afarhan/antuino/antuino_schematic.pdf

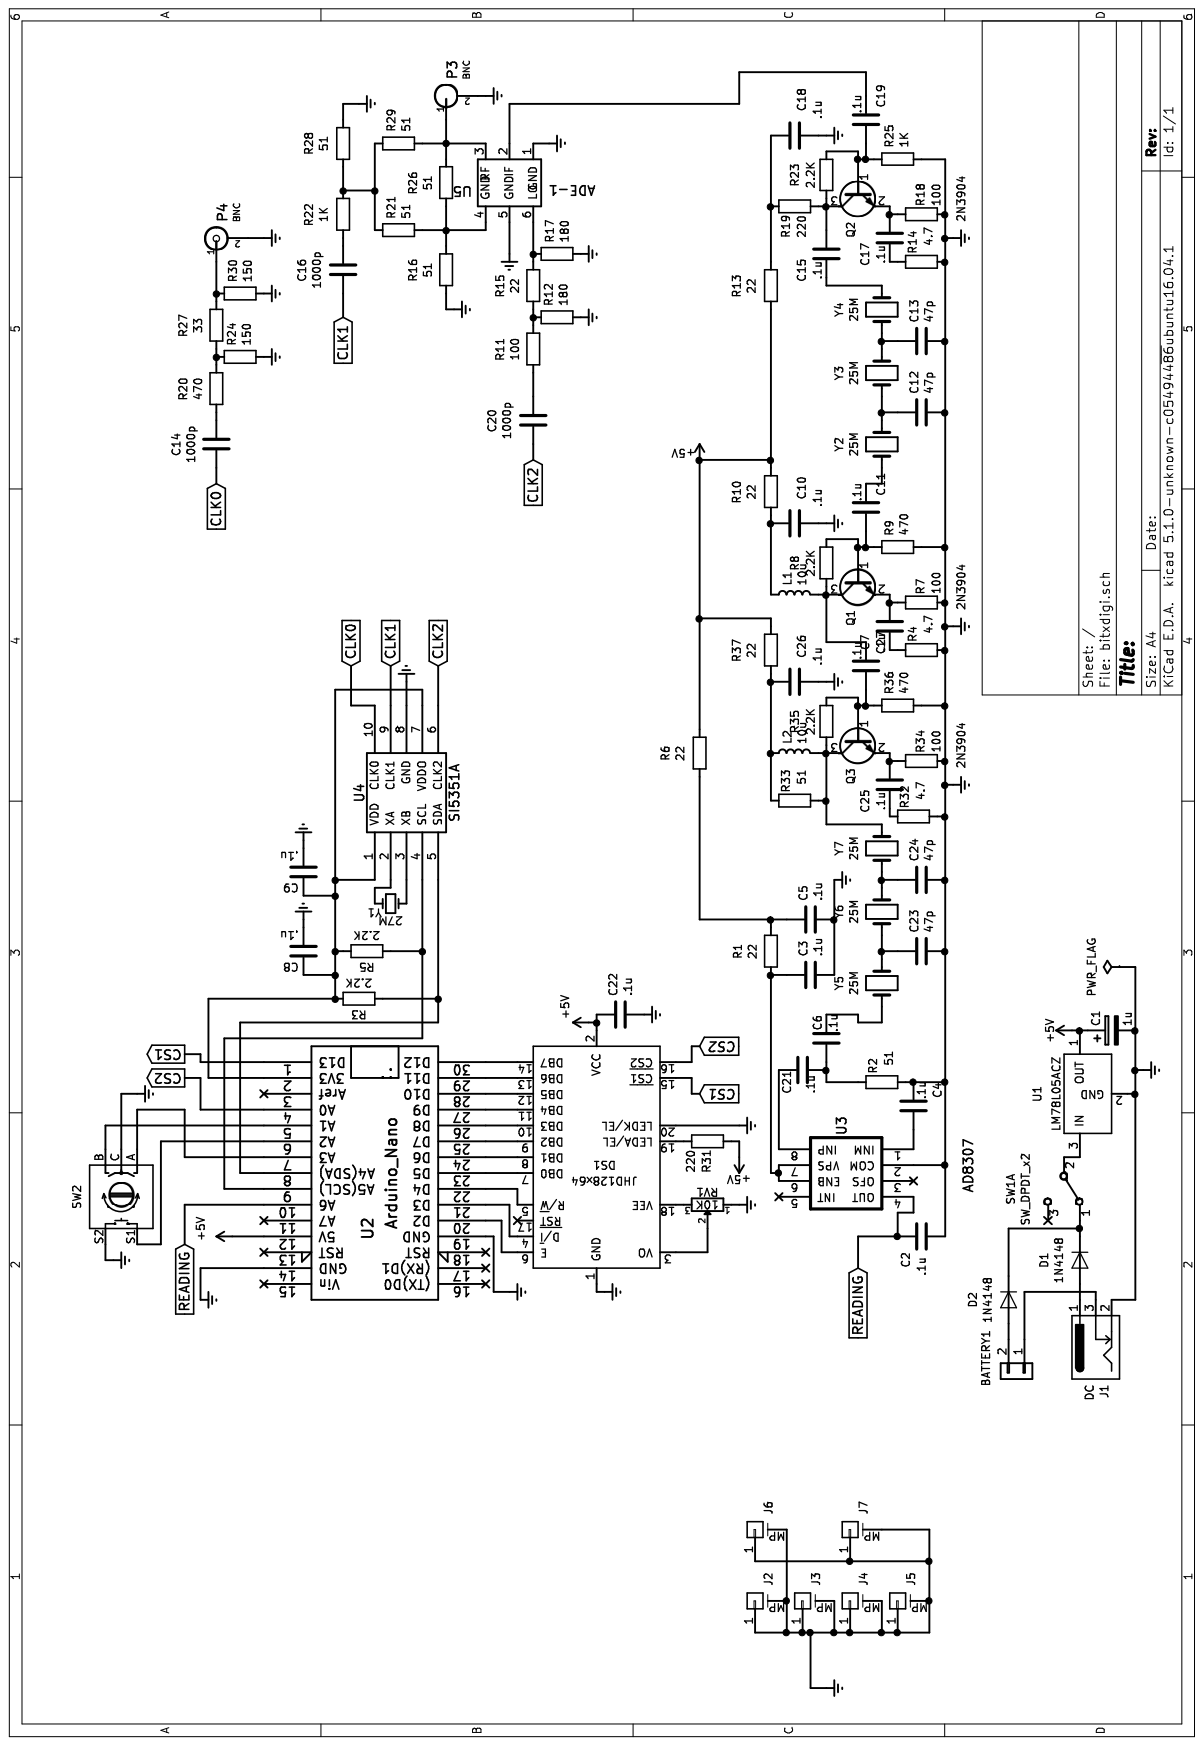
[picture p1: page 1]
